Zanz-19/frecuencimetro-asic/(commit log)

2026-06-15 Fase 1: estructura del proyecto y documentación de especificaciones
    - spec/spec.md: parámetros de medición y restricciones de Caravel
    - spec/pin_map.md: asignación de pines io_in/io_out/analógicos/Wishbone
    - spec/module_list.md: contratos de interfaz de los 8 módulos RTL
    - spec/project_tree.md: árbol de archivos con estado por fase
    - README.md: descripción general del proyecto
    - Estructura de carpetas completa lista para Fases 2-7
2026-06-15 Fase 1: agregar IPs como submódulos git
    - ip/dac_r2r: mattvenn/tt06-analog-r2r-dac (DAC R-2R 8b)
    - ip/adc_sar: chipfoundry/sky130_ef_ip__adc3v_12bit (ADC SAR 12b)
2026-06-16 Fase 1: actualizar spec con pines reales verificados (v2.0)
    - pin_map.md v2.0: pines reales de DAC y ADC confirmados desde código fuente
    - module_list.md v2.0: interfaces corregidas (reset DAC invertido, soc vs start, swidth)
    - project_tree.md v2.0: estructura real de repos clonados con archivos clave mapeados
2026-06-16 Fase 1: cerrar especificaciones con pines 100% verificados (v3.0)
    - pin_map.md v3.0: pines analógicos ADC confirmados desde SPICE (adc_in,
    adc_dac_val[11:0], adc_comp_out); SIZE=12 confirmado; reset DAC 3V
    identificado como pendiente; referencias vrefH/vrefL/vCM añadidas
    - project_tree.md v3.0: archivos clave marcados con rol por fase;
    mapa de archivos IP → fase de uso
    - module_list.md v2.0: sin cambios adicionales
2026-06-17 Fase 2: cdc_sync.v verificado — 12/12 tests pasaron
    - Sincronizador 2-FF con atributo keep para síntesis
    - Tests: reset, latencia exacta, 4 offsets de fase, pulso corto, reset en propagacion
    [cdc_sync.v, tb_cdc_sync.v]
2026-06-17 Fase 2: agregar Makefile para automatizar simulaciones
    - make sim MODULE=<nombre>: compila y corre testbench con iverilog
    - make wave MODULE=<nombre>: abre GTKWave con el .vcd generado
    - make clean: limpia archivos generados
    - make list: lista módulos disponibles en rtl/
    - .gitignore actualizado: build/, *.vvp, *.vcd ya no se trackean
2026-06-17 Fix: corregir backgrounding de gtkwave en target wave del Makefile
    - Antes: & al final de la receta confundía a make, dejaba proceso colgado
    - Ahora: & dentro de la misma instrucción shell, libera la terminal correctamente
    - Bonus: silencia el warning de canberra-gtk-module
2026-06-17 Fase 2: gate_timer.v verificado — 12/12 tests pasaron
    - Generador de ventana T_gate configurable (27 bits, hasta 1.34s @ 100MHz)
    - FSM de 2 estados: IDLE/RUNNING
    - Tests: reset, duracion exacta (10 y 1000 ciclos), pulso gate_done de 1 ciclo,
    start ignorado durante ventana activa, reset corta ventana activa,
    gate_cycles=0 invalido, dos ciclos de medicion consecutivos
    [gate_timer.v, tb_gate_timer.v]
2026-06-17 Fase 2: freq_counter.v verificado — 9/9 tests pasaron
    - Contador de 32 bits, detecta flancos de subida de fx_in durante gate_en=1
    - count_valid como pulso de 1 ciclo tras bajar gate_en
    - cnt_reset con prioridad sobre conteo simultaneo
    - Tests: reset, medicion basica 10MHz, conteo exacto manual,
    pulso count_valid, flanco fuera de ventana ignorado,
    prioridad de reset, mediciones consecutivas independientes
    [freq_counter.v, tb_freq_counter.v]
2026-06-18 Fase 2: result_latch.v verificado — 14/14 tests pasaron
    - Registro de captura: actualiza data_out en cada pulso de latch_en
    - data_ready persiste tras la primera captura (no es un pulso)
    - Tests: reset, primera/segunda captura, estabilidad sin latch_en,
    persistencia de data_ready, valores de esquina (0 y 0xFFFFFFFF),
    reset tras capturas previas, latch_en sostenido varios ciclos
    [result_latch.v, tb_result_latch.v]
2026-06-18 Fase 2: adc_ctrl.v verificado — 13/13 tests pasaron
    - Controlador del ADC SAR: orquesta sar_ctrl real de la IP (no un mock)
    - Timing soc->eoc verificado empiricamente: 15+swidth ciclos con SIZE=12
    - Modos single-shot y continuo, FSM de 4 estados
    - Tests con sar_ctrl real: valores min/medio/max/arbitrario, pulso soc,
    no-repeticion en single-shot, encadenamiento en modo continuo,
    reset durante conversion en curso
    Makefile: agregar soporte EXTRA_SRC para compilar modulos que dependen
    de IPs externas reales (ip/adc_sar/, ip/dac_r2r/)
    [adc_ctrl.v, tb_adc_ctrl.v]
2026-06-19 Fase 2: dac_ctrl.v verificado — 20/20 tests pasaron
    - Controlador del DAC R-2R: interfaz con r2r_dac_control real
    - HALLAZGO IMPORTANTE: la IP usa n_rst como enable activo-alto, no como
    reset invertido. Conexion correcta: dac_n_rst = rst_n (sin inversion)
    - Modos externo (dato estatico) y selftest (rampa interna de la IP)
    - Tests con la IP real: reset, modo externo con valores de esquina,
    transicion a selftest, carga de divisor, rampa incrementando,
    regreso a modo externo, reset durante operacion
    Makefile: corregir manejo de .vcd cuando una IP externa fuerza su propio
    nombre de dumpfile. Fix simplificado: borrar .vcd sueltos ANTES de
    ejecutar, asi cualquiera que aparezca despues es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
    [dac_ctrl.v, tb_dac_ctrl.v]
2026-06-20 Fase 2: wb_regs.v verificado — 30/30 tests pasaron
    - Decodificador Wishbone: 6 registros (FREQ_RESULT, GATE_CFG, ADC_DATA,
    DAC_WORD, STATUS, CTRL)
    - CTRL decodifica 6 campos de configuracion en un solo registro de escritura
    - soft_rst y dac_load_div como pulsos de 1 ciclo con auto-clear
    - Tests: defaults tras reset, R/W de GATE_CFG y DAC_WORD, registros de
    solo lectura reflejando entradas externas, decodificacion bit a bit
    de CTRL, comportamiento pulso vs persistente, regla stb+cyc para ack,
    direccion no mapeada, reset restaura defaults tras escrituras previas
    [tb_wb_regs.v, wb_regs.v]
2026-06-20 Fase 2 completada: actualizar specs con hallazgos verificados (110/110 tests)
    - pin_map.md v4.0: CORRIGE polaridad de reset del DAC (v3.0 decia invertir,
    la simulacion real demuestra que NO se invierte: dac_n_rst = rst_n)
    - pin_map.md v4.0: confirma timing soc->eoc del ADC = 15+swidth ciclos
    - module_list.md v3.0: documenta 7/8 modulos verificados con su cobertura
    de tests y bugs encontrados; agrega checklist de integracion freq_top.v
    - spec.md: actualiza estado Fase 2, agrega resumen ejecutivo de hallazgos
    - project_tree.md v4.0: marca modulos verificados, agrega Makefile al arbol
2026-06-21 Fase 2 COMPLETA: freq_top.v verificado — 12/12 tests (118/118 acumulados)
    - freq_top.v: integra los 7 modulos verificados + FSM de secuenciacion general
    - adc_ctrl.v: agrega puerto swidth (pass-through desde wb_regs), 13/13 sigue intacto
    HALLAZGO CRITICO DE INTEGRACION: sar_ctrl.data solo es valido durante 1 ciclo
    (estado DONE); cdc_sync introduce 2 ciclos de latencia en la notificacion eoc.
    El dato se perdia antes de que adc_ctrl pudiera reaccionar a eoc_sync.
    Solucion: registro de captura inmediata (adc_data_latch) en freq_top.v,
    disparado por adc_eoc CRUDO (sin sincronizar) ya que es un registro de datos,
    no de control -- la notificacion sigue pasando por cdc_sync para timing seguro.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
2026-06-21 Actualizar README: Fase 2 completada (118/118 tests, 8/8 modulos)
    - Marcar Fase 2 como completada con tabla de detalle por modulo
    - Documentar los 2 hallazgos criticos de la integracion con IPs reales
    - Agregar comandos make sim/wave de referencia rapida
    - Aclarar que Fase 2 completada NO equivale a chip funcional:
    faltan Fase 4 (Schmitt trigger) y Fase 6 (sintesis fisica) como
    piezas bloqueantes para llegar a un GDS fabricable
2026-06-23 Fase 3: suite cocotb 2.0 - 3/3 tests pasando
    Barrido de frecuencias (0.00% error), selftest DAC->Schmitt->contador,
    y ADC en paralelo. Usa cocotb_tools.runner (API de cocotb 2.0).
    [error_analysis.py, runner.py, tb_top.v, test_freq_top.py]
2026-06-23 Agregar target 'make cocotb' para correr la suite de Fase 3
2026-06-23 Ignorar artefactos generados por la suite de Fase 3
2026-06-29 Fase 4: sizing final del Schmitt trigger (MP_FB/MN_FB W=16/8 L=64um)
    [schmitt_trigger.sch]
2026-06-29 Fase 4: testbench PVT consolidado del Schmitt trigger (12 casos proceso x temperatura)
2026-06-30 Fase 4/5: mover netlists de simulacion de xschem/ a sim/ (project_tree.md)
2026-06-30 Fase 5: corregir Makefile para apuntar a sim/ en vez de xschem/
2026-06-30 Fase 4/5: separar correctamente esquematico (Fase 4) de caracterizacion ngspice (Fase 5) en spec.md
2026-06-30 Fase 4/5: separar correctamente esquematico (Fase 4) de caracterizacion ngspice (Fase 5) en README
